mjonuschat/voron-swingarm/Images/swingarm-render.png

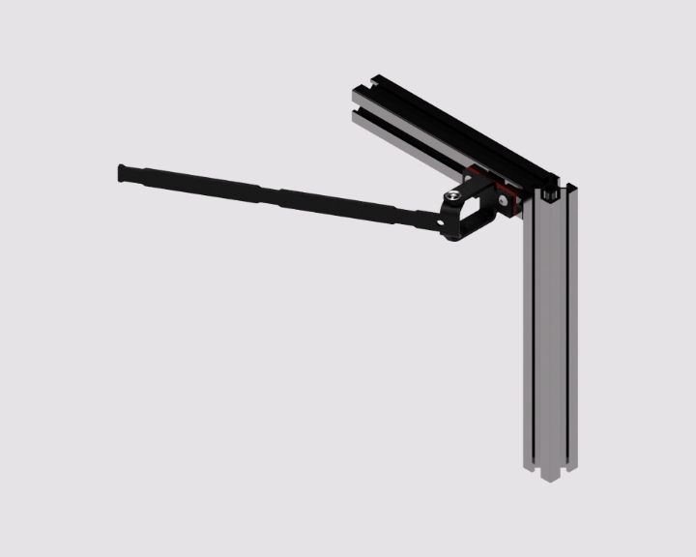
Images/swingarm-render.png
