mjonuschat/voron-swingarm/CAD/VORON SwingArm - 2020 Mount.step

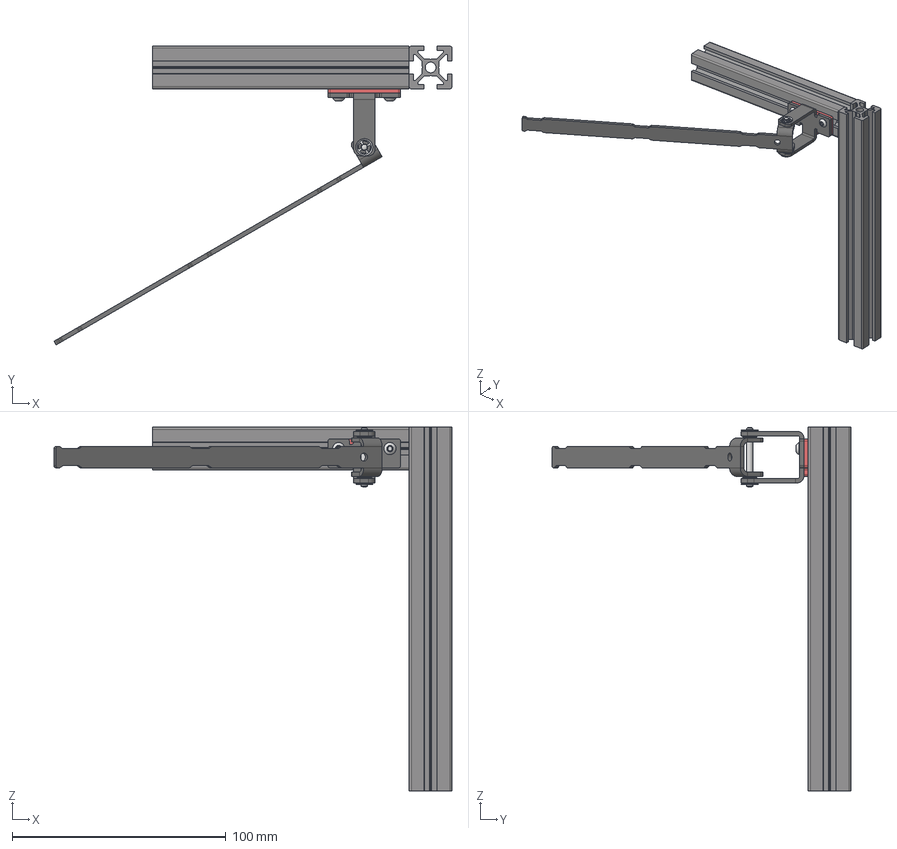
[picture p4: CAD file, 2025-11-27]
CAD/VORON SwingArm - 2020 Mount.step
186.1 x 139.7 x 170.0 mm
Swing Arm
Držák ramínka A1
90718A110_Electrical-Insulating Nylon Washer x 2
92133A104_Push-on External Retaining Rings x 2
91595A133_Dowel Pin
M3 Roll-In T Nut x 2
M3x8 BHCS x 2
2020 - Vertical
2020 - Horizontal
Extrusion Protector
