mjonuschat/voron-swingarm/Metal Parts/swingarm.step

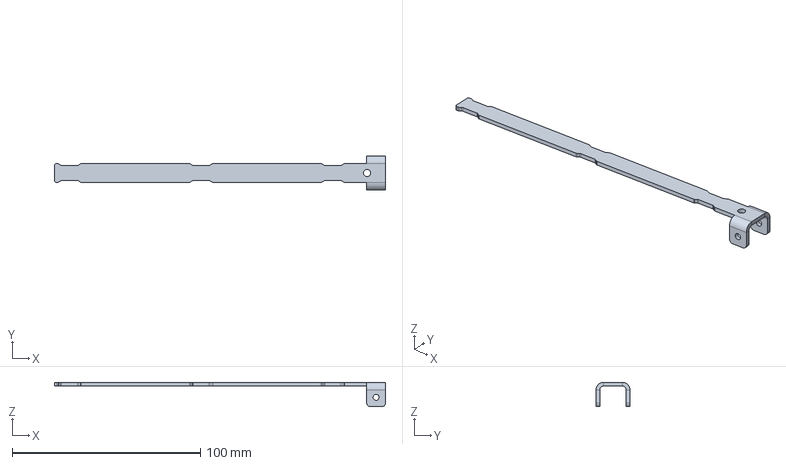
[picture p5: CAD file, 2025-11-27]
Metal Parts/swingarm.step
176.0 x 18.0 x 13.0 mm
