mjonuschat/voron-swingarm/Printed Parts/extrusion-protector.stl

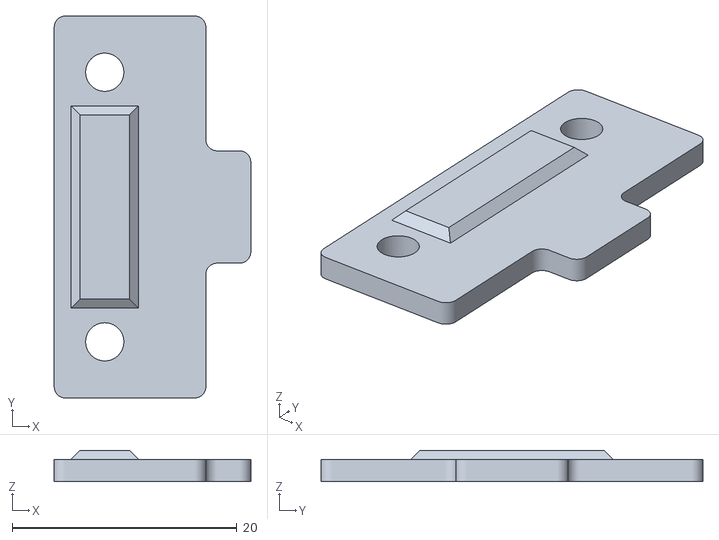
[picture p6: CAD file, 2025-11-27]
Printed Parts/extrusion-protector.stl
17.5 x 34.0 x 2.80
