mjonuschat/voron-swingarm/Metal Parts/mount.step

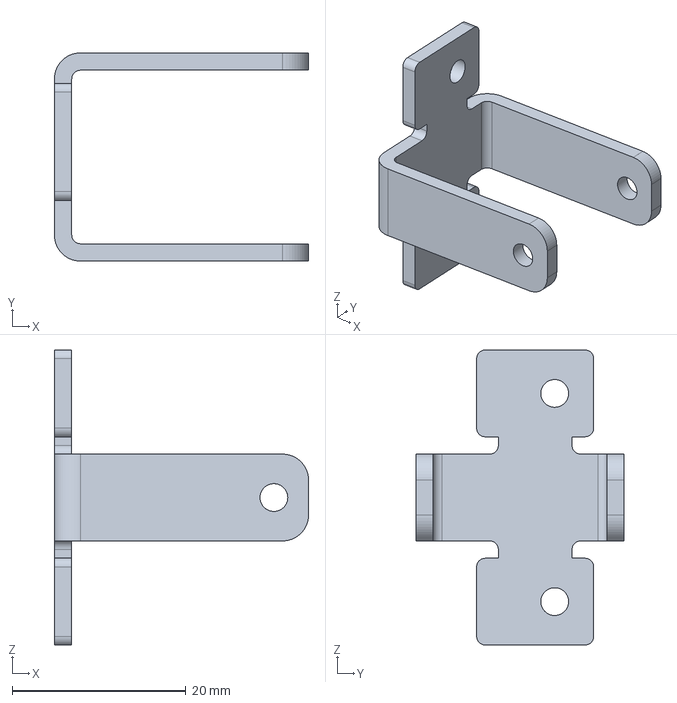
[picture p7: CAD file, 2025-11-27]
Metal Parts/mount.step
29.3 x 24.0 x 34.0 mm
