mjonuschat/voron-swingarm/(commit log)

2025-11-27 Initial Release
    [extrusion-protector.stl, mount.step, swingarm.step]
2025-11-27 Add CAD source
    [VORON SwingArm - 2020 Mount.step]
